ToxquiM/Ball-And-Beam-Arduino/ball and beam esquemático_page-0001.jpg

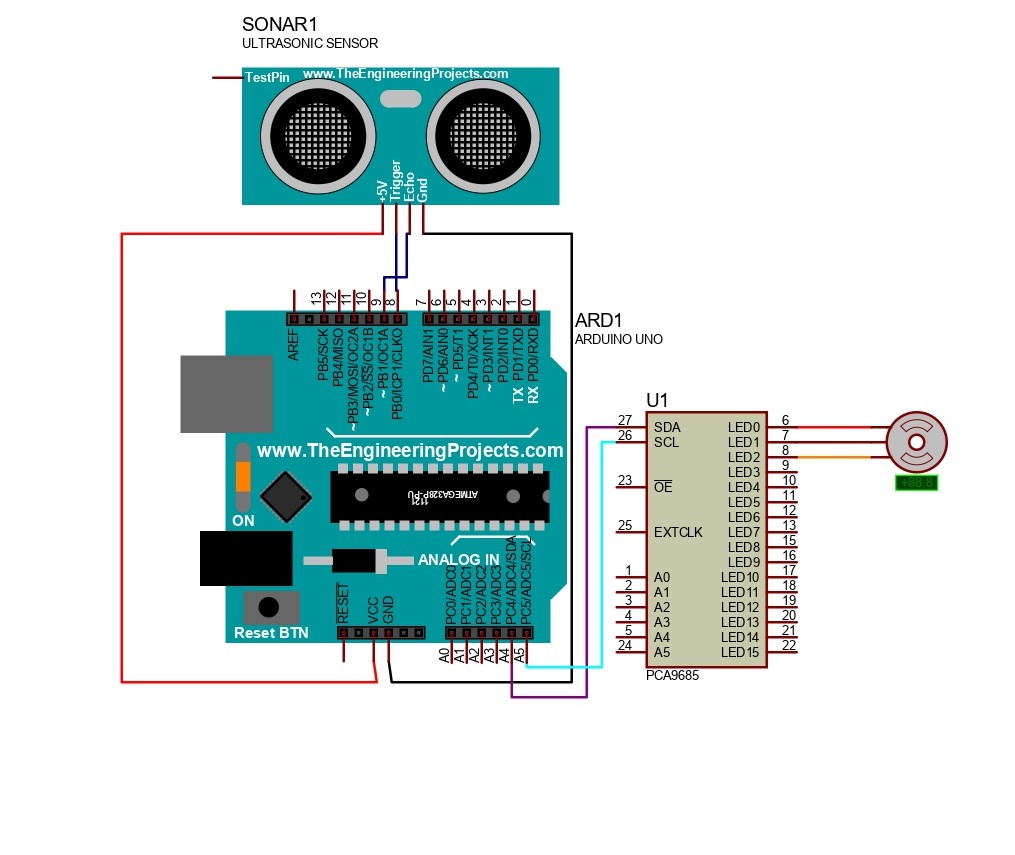
ball and beam esquemático_page-0001.jpg
