ToxquiM/Ball-And-Beam-Arduino/Piezas 3D/CAJERA.stl

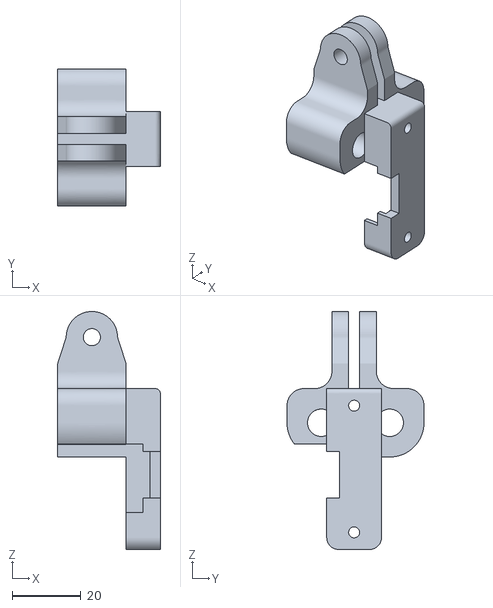
[picture p2: CAD file, 2025-06-30]
Piezas 3D/CAJERA.stl
30.0 x 40.0 x 69.5
