ToxquiM/Ball-And-Beam-Arduino/Piezas 3D/BASE ULTRASONIDO 2.3mf

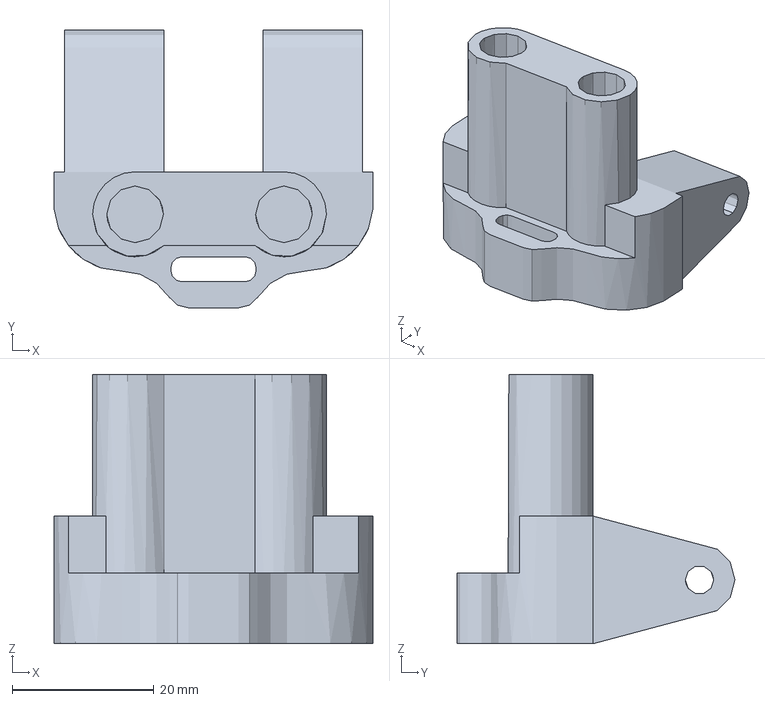
[picture p3: CAD file, 2025-06-30]
Piezas 3D/BASE ULTRASONIDO 2.3mf
45.0 x 39.2 x 38.0 mm
