ToxquiM/Ball-And-Beam-Arduino/Piezas 3D/BAASE ULTRASONIDO 1.3mf

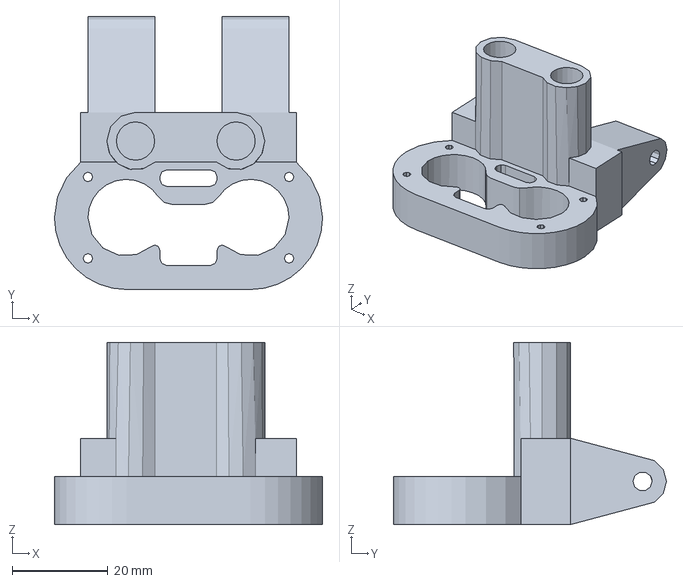
[picture p4: CAD file, 2025-06-30]
Piezas 3D/BAASE ULTRASONIDO 1.3mf
56.0 x 57.0 x 38.0 mm
