ToxquiM/Ball-And-Beam-Arduino/Piezas 3D/ENGRANAJE CIRCULAR SERVO.3mf

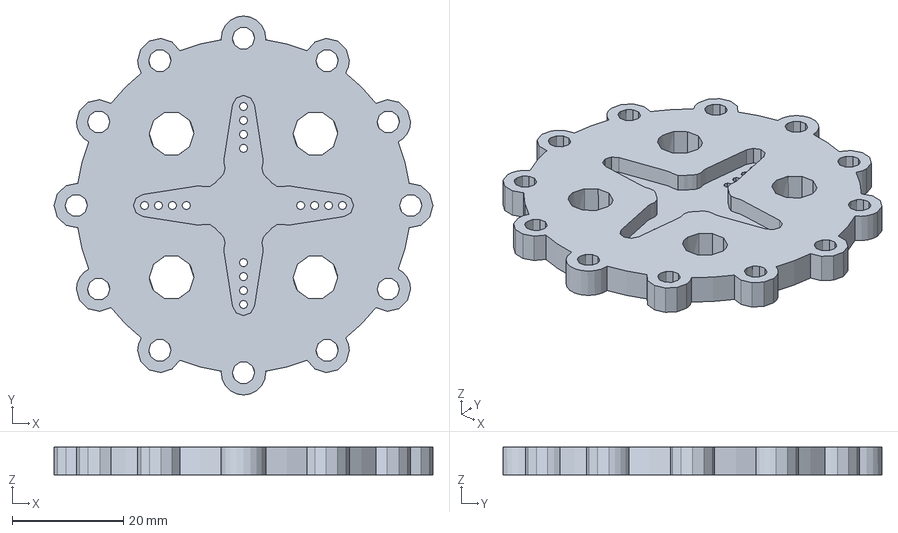
[picture p5: CAD file, 2025-06-30]
Piezas 3D/ENGRANAJE CIRCULAR SERVO.3mf
68.0 x 68.0 x 5.00 mm
