ToxquiM/Ball-And-Beam-Arduino/Piezas 3D/BASE SERVO.3mf

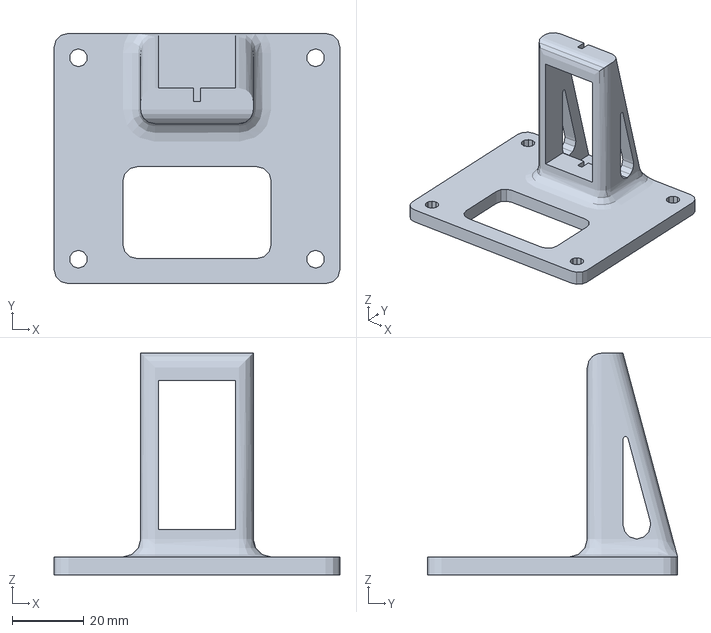
[picture p6: CAD file, 2025-06-30]
Piezas 3D/BASE SERVO.3mf
80.0 x 70.0 x 62.0 mm
