ToxquiM/Ball-And-Beam-Arduino/Piezas 3D/BIELA.3mf

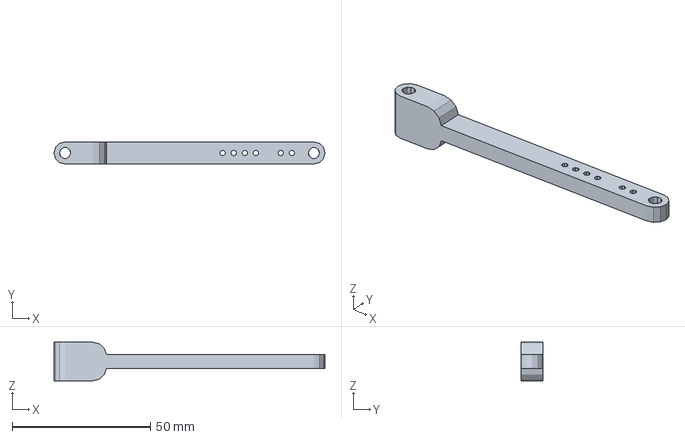
[picture p7: CAD file, 2025-06-30]
Piezas 3D/BIELA.3mf
98.0 x 8.00 x 14.0 mm
