ToxquiM/Ball-And-Beam-Arduino/Piezas 3D/BASE GRANDE.3mf

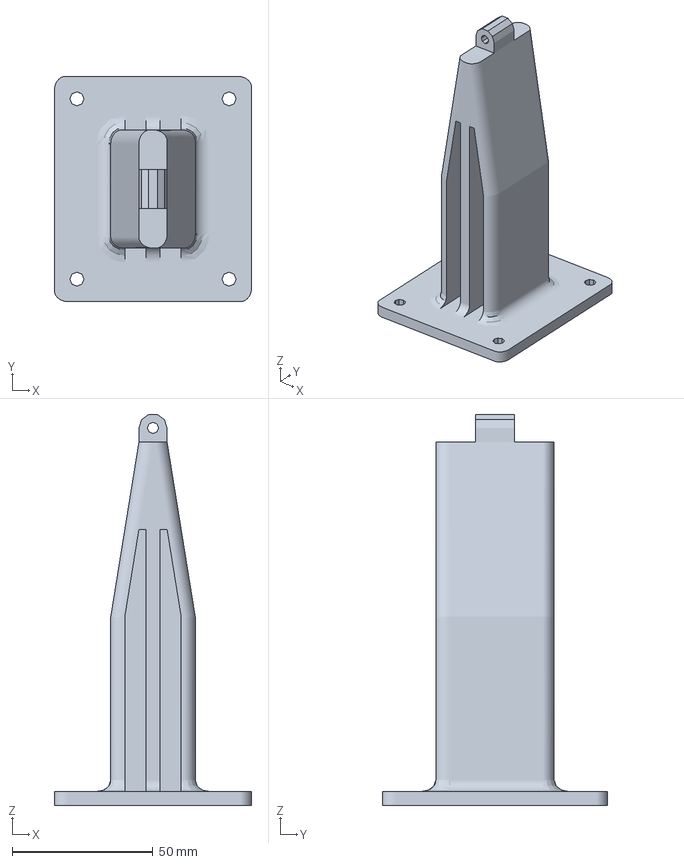
[picture p8: CAD file, 2025-06-30]
Piezas 3D/BASE GRANDE.3mf
70.0 x 80.0 x 138.8 mm
