ToxquiM/Ball-And-Beam-Arduino/(commit log)

2025-06-30 Piezas 3D
    [BAASE ULTRASONIDO 1.3mf, BASE GRANDE.3mf, BASE SERVO.3mf, BASE ULTRASONIDO 2.3mf, BIELA.3mf, ENGRANAJE CIRCULAR SERVO.3mf]
2025-06-30 Código en Arduino
2025-06-30 Link de descarga app interfaz grafica
2025-06-30 Código de app
2025-07-01 Manual de usuario
2025-07-01 Manual de usuario y Esquematico.
2025-07-01 Ball And Beam 15 cm
    código para mantener la bola solo en el centro de la viga
